jaydenaleung/logic-gate-calculator/pcb/3d_models/CD74HC283E.stp

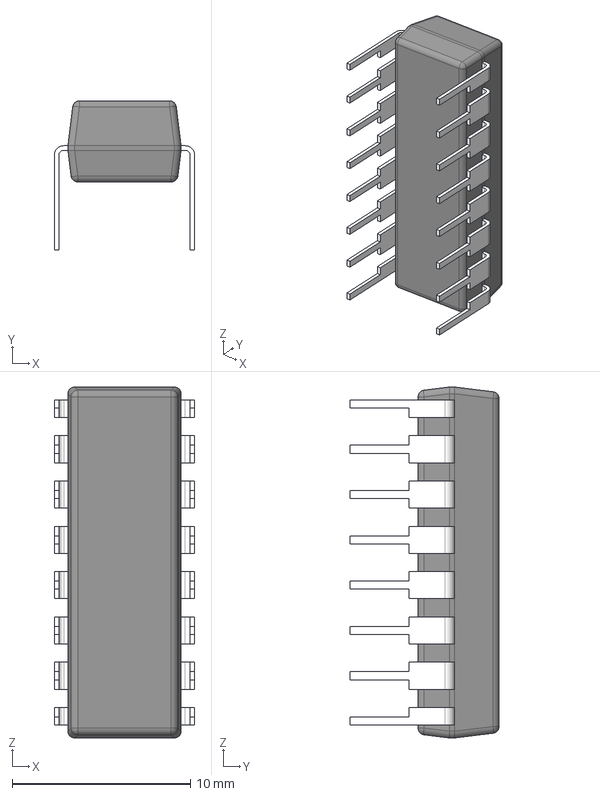
[picture p1: CAD file, 2026-03-24]
pcb/3d_models/CD74HC283E.stp
7.87 x 8.37 x 19.7 mm
BODY_N0016A_AF0
LEAD_N0016A_AF1
LEAD_N0016A x 10
LEAD_N0016A_AF3
LEAD_N0016A_AF5
LEAD_N0016A_AF0
LEAD_N0016A_AF2
LEAD_N0016A_AF4
