jaydenaleung/logic-gate-calculator/pcb/3d_models/SN74HC04N.stp

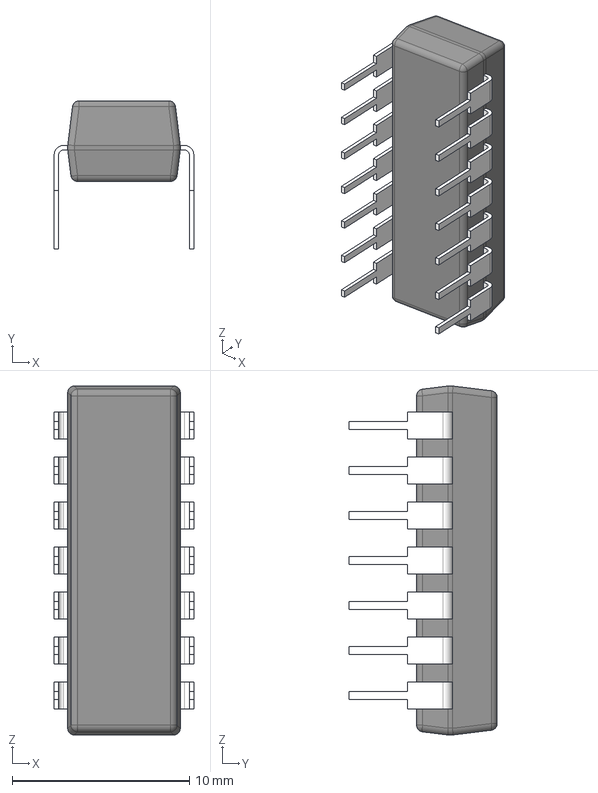
[picture p2: CAD file, 2026-03-24]
pcb/3d_models/SN74HC04N.stp
7.87 x 8.37 x 19.7 mm
BODY_N0014A_AF0
LEAD_N0014A_AF1
LEAD_N0014A x 10
LEAD_N0014A_AF3
LEAD_N0014A_AF0
LEAD_N0014A_AF2
