jaydenaleung/logic-gate-calculator/pcb/3d_models/L7805CV.STEP

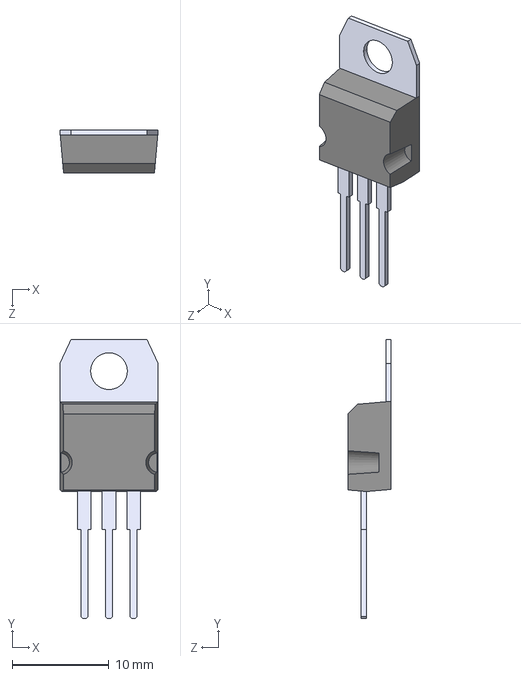
[picture p3: CAD file, 2026-03-24]
pcb/3d_models/L7805CV.STEP
10.2 x 28.9 x 4.50 mm
