jaydenaleung/logic-gate-calculator/pcb/logic-gate-calculator.kicad_pcb

## KiCad design pcb/logic-gate-calculator.kicad_pcb (2026-07-14)

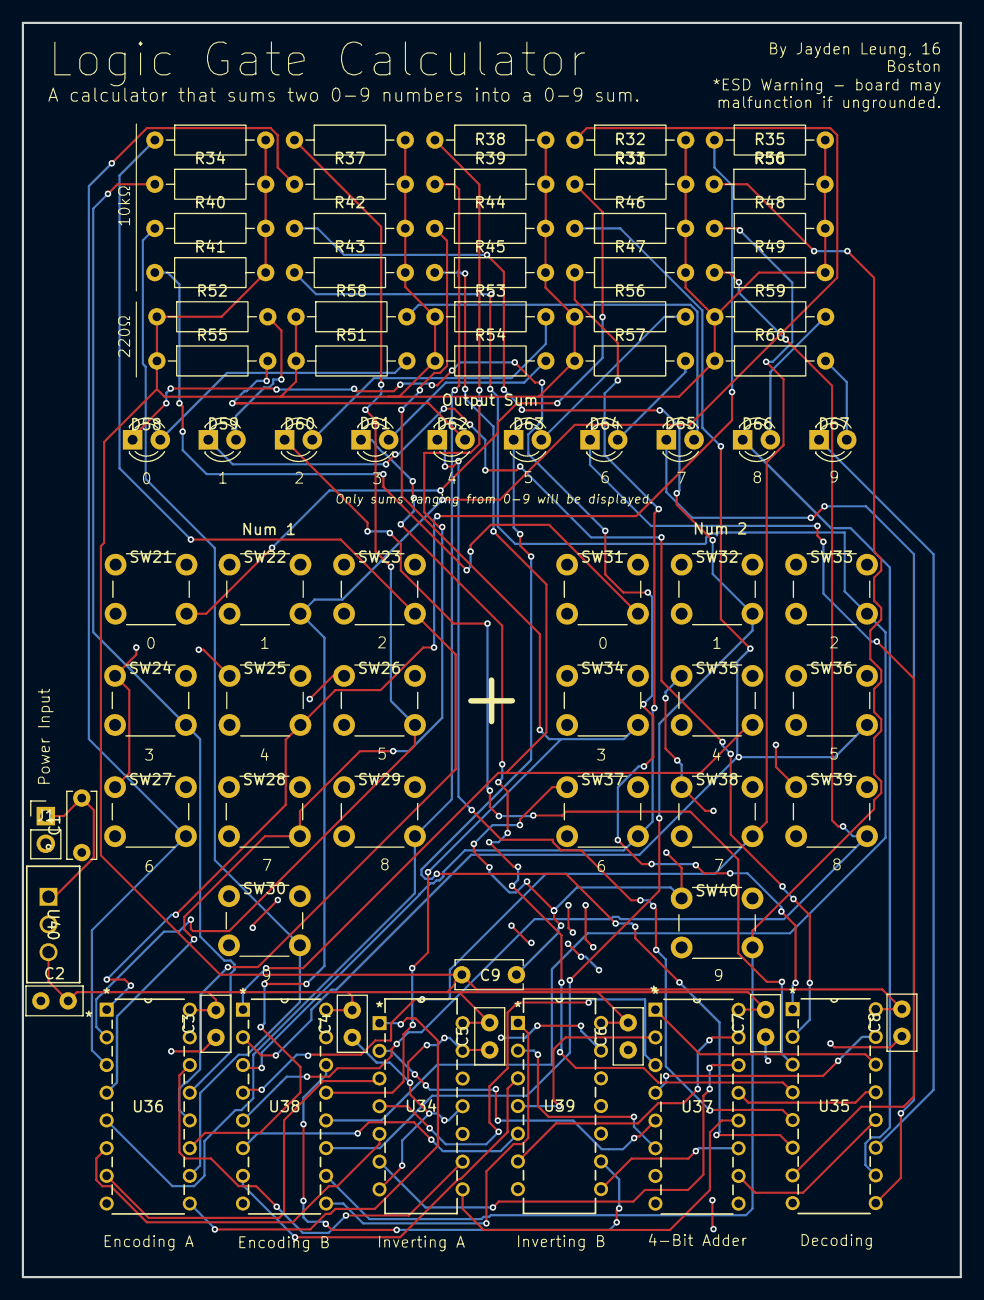
[picture p4: board logic-gate-calculator.kicad_pcb from above]

Board: 2 copper layers, 86.0 x 115.0 mm, 77 parts (0 on the bottom side), 63 nets.

Parts:
C1, C9: 2.2µF; C_Disc_D6.0mm_W2.5mm_P5.00mm
C2, C3, C4, C5, C6, C7, C8: 0.1µF; C_Disc_D5.0mm_W2.5mm_P2.50mm
D58, D59, D60, D61, D62, D63, D64, D65, D66, D67: LED; LED_D3.0mm
J1: Power_Dupont_Socket_Connector; PinHeader_1x02_P2.54mm_Vertical
R31, R32, R33, R34, R35, R36, R37, R38, R39, R40, R41, R42, R43, R44, R45, R46, R47, R48, R49, R50: 10kΩ; R_Axial_DIN0207_L6.3mm_D2.5mm_P10.16mm_Horizontal
R51, R52, R53, R54, R55, R56, R57, R58, R59, R60: 220Ω; R_Axial_DIN0207_L6.3mm_D2.5mm_P10.16mm_Horizontal
SW21: SW_0_in_A; SW_PUSH_6mm
SW22: SW_1_in_A; SW_PUSH_6mm
SW23: SW_2_in_A; SW_PUSH_6mm
SW24: SW_3_in_A; SW_PUSH_6mm
SW25: SW_4_in_A; SW_PUSH_6mm
SW26: SW_5_in_A; SW_PUSH_6mm
SW27: SW_6_in_A; SW_PUSH_6mm
SW28: SW_7_in_A; SW_PUSH_6mm
SW29: SW_8_in_A; SW_PUSH_6mm
SW30: SW_9_in_A; SW_PUSH_6mm
SW31: SW_0_in_B; SW_PUSH_6mm
SW32: SW_1_in_B; SW_PUSH_6mm
SW33: SW_2_in_B; SW_PUSH_6mm
SW34: SW_3_in_B; SW_PUSH_6mm
SW35: SW_4_in_B; SW_PUSH_6mm
SW36: SW_5_in_B; SW_PUSH_6mm
SW37: SW_6_in_B; SW_PUSH_6mm
SW38: SW_7_in_B; SW_PUSH_6mm
SW39: SW_8_in_B; SW_PUSH_6mm
SW40: SW_9_in_B; SW_PUSH_6mm
U34, U39: N14; SN74HC04N
U35: N16; SN74HC42N
U36, U38: N16; CD74HC147E
U37: N16; CD74HC283E
U40: L7805; L7805CV

Connections:
0_in_A: R31.1, SW21.4
0_in_B: R41.1, SW31.4
0_out: C1.1, C2.1, C3.1, C4.1, C5.1, C6.1, C7.1, C8.1, C9.2, J1.2, SW21.1, SW22.1, SW23.1, SW24.1, SW25.1, SW26.1, SW27.1, SW28.1, SW29.1, SW30.1, SW31.1, SW32.1, SW33.1, SW34.1, SW35.1, SW36.1, SW37.1, SW38.1, SW39.1, SW40.1, U34.7 (GND), U34.11 (5A), U34.13 (6A), U35.8 (GND), U36.8 (GND), U37.7 (CIN), U37.8 (GND), U38.8 (GND), U39.7 (GND), U39.11 (5A), U39.13 (6A), U40.2 (GND)
00_out_A_AH: U34.4 (2Y), U37.3 (A1)
0_out_A_AH: U34.2 (1Y), U37.5 (A0)
0000_out_A_AH: U34.8 (4Y), U37.12 (A3)
000_out_A_AH: U34.6 (3Y), U37.14 (A2)
0_out_A_AL: U34.1 (1A), U36.9 (*Y0)
00_out_A_AL: U34.3 (2A), U36.7 (*Y1)
000_out_A_AL: U34.5 (3A), U36.6 (*Y2)
0000_out_A_AL: U34.9 (4A), U36.14 (*Y3)
00_out_B_AH: U37.2 (B1), U39.4 (2Y)
0_out_B_AH: U37.6 (B0), U39.2 (1Y)
0000_out_B_AH: U37.11 (B3), U39.8 (4Y)
000_out_B_AH: U37.15 (B2), U39.6 (3Y)
0_out_B_AL: U38.9 (*Y0), U39.1 (1A)
00_out_B_AL: U38.7 (*Y1), U39.3 (2A)
000_out_B_AL: U38.6 (*Y2), U39.5 (3A)
0000_out_B_AL: U38.14 (*Y3), U39.9 (4A)
1_in_A: R32.1, SW22.4, U36.11 (*I1)
1_in_B: R42.1, SW32.4, U38.11 (*I1)
2_in_A: R33.1, SW23.4, U36.12 (*I2)
2_in_B: R43.1, SW33.4, U38.12 (*I2)
3_in_A: R34.1, SW24.4, U36.13 (*I3)
3_in_B: R44.1, SW34.4, U38.13 (*I3)
4_in_A: R35.1, SW25.4, U36.1 (*I4)
4_in_B: R45.1, SW35.4, U38.1 (*I4)
5_in_A: R36.1, SW26.4, U36.2 (*I5)
5_in_B: R46.1, SW36.4, U38.2 (*I5)
6_in_A: R37.1, SW27.4, U36.3 (*I6)
6_in_B: R47.1, SW37.4, U38.3 (*I6)
7_in_A: R38.1, SW28.4, U36.4 (*I7)
7_in_B: R48.1, SW38.4, U38.4 (*I7)
8_in_A: R39.1, SW29.4, U36.5 (*I8)
8_in_B: R49.1, SW39.4, U38.5 (*I8)
9_in_A: R40.1, SW30.4, U36.10 (*I9)
9_in_B: R50.1, SW40.4, U38.10 (*I9)
+5V: C2.2, C3.2, C4.2, C5.2, C6.2, C7.2, C8.2, C9.1, R31.2, R32.2, R33.2, R34.2, R35.2, R36.2, R37.2, R38.2, R39.2, R40.2, R41.2, R42.2, R43.2, R44.2, R45.2, R46.2, R47.2, R48.2, R49.2, R50.2, R51.1, R52.1, R53.1, R54.1, R55.1, R56.1, R57.1, R58.1, R59.1, R60.1, U34.14 (VCC), U35.16 (VCC), U36.16 (VCC), U37.16 (VCC), U38.16 (VCC), U39.14 (VCC), U40.3 (OUT)
+PWR_OUTPUT: C1.2, J1.1, U40.1 (IN)
LED_0: D58.1 (K), U35.1 (0)
LED_1: D59.1 (K), U35.2 (1)
LED_2: D60.1 (K), U35.3 (2)
LED_3: D61.1 (K), U35.4 (3)
LED_4: D62.1 (K), U35.5 (4)
LED_5: D63.1 (K), U35.6 (5)
LED_6: D64.1 (K), U35.7 (6)
LED_7: D65.1 (K), U35.9 (7)
LED_8: D66.1 (K), U35.10 (8)
LED_9: D67.1 (K), U35.11 (9)
unnamed: D58.2 (A), R51.2
unnamed: D59.2 (A), R52.2
unnamed: D60.2 (A), R53.2
unnamed: D61.2 (A), R54.2
unnamed: D62.2 (A), R55.2
unnamed: D63.2 (A), R56.2
unnamed: D64.2 (A), R57.2
unnamed: D65.2 (A), R58.2
unnamed: D66.2 (A), R59.2
unnamed: D67.2 (A), R60.2
SUM_0000: U35.12 (D), U37.10 (S3)
SUM_000: U35.13 (C), U37.13 (S2)
SUM_00: U35.14 (B), U37.1 (S1)
SUM_0: U35.15 (A), U37.4 (S0)
