jaydenaleung/logic-gate-calculator/(commit log)

2026-03-24 Finish schematic except arduino interface
    [CD74HC147E.stp, CD74HC283E.stp, L7805CV.STEP, SN74HC04N.stp, SN74HC42N.stp, logic-gate-calculator.kicad_pcb, logic-gate-calculator.kicad_sch]
2026-03-28 finish pcb and upload gerbers and step
    [logic-gate-calculator.kicad_pcb, logic-gate-calculator.kicad_sch]
2026-07-14 fix numbering
    [logic-gate-calculator.kicad_pcb]
